kennych418/Multichannel-BT-Keyboard/Keyboard_BOM.xlsx

Sheet: Sheet1
Vendor | Package | Description | Quantity | Unit Price | Total Cost | Link | Datasheet
MODULES
Digikey | Module | BT Module HID & SPP | 3 | 15.73 | 47.19 | https://www.digikey.com/product-detail/en/microchip-technology/RN42-I-RM630/RN42-I-RM630-ND/6009311
Digikey | 402 | 10k Resistor | 4 | 0.1 | 0.4 | https://www.digikey.com/product-detail/en/yageo/RC0402FR-0710KL/311-10.0KLRCT-ND/729470
Digikey |  | AtMega32u4 | 1 | 4.2 | 4.2 | https://www.digikey.com/product-detail/en/microchip-technology/ATMEGA32U4-AUR/ATMEGA32U4-AURCT-ND/3440960
Digikey | HC-49/US | 16 MHz Crystal | 1 | 0.46 | 0.46 | https://www.digikey.com/product-detail/en/abracon-llc/ABLS2-16.000MHZ-D4Y-T/535-9875-1-ND/2001498
Digikey | 402 | 22pF Capacitor | 4 | 0.65 | 2.6 | https://www.digikey.com/product-detail/en/avx-corporation/04025A220FAT2A/478-5765-1-ND/2136357
Digikey | 402 | 10uF Capacitor | 2 | 0.47 | 0.94 | https://www.digikey.com/product-detail/en/samsung-electro-mechanics/CL05A106MP8NUB8/1276-6830-1-ND/5961689
Digikey | 402 | 1uF Capacitor | 2 | 0.1 | 0.2 | https://www.digikey.com/product-detail/en/samsung-electro-mechanics/CL05A105JQ5NNNC/1276-1444-1-ND/3889530
DECOUPLING
Digikey | 402 | 4.7uF Capacitor | 2 | 0.15 | 0.3 | https://www.digikey.com/product-detail/en/murata-electronics/GRM155R60J475ME47D/490-5915-1-ND/3719860
Digikey | 402 | 100nF Capacitor | 6 | 0.1 | 0.6 | https://www.digikey.com/product-detail/en/samsung-electro-mechanics/CL05B104KO5NNNC/1276-1001-1-ND/3889087
Battery
Digikey | Throughhole | Battery Clip | 8 | 0.32 | 2.56 | https://www.digikey.com/product-detail/en/keystone-electronics/92/36-92-ND/82326
USB
Digikey |  | Micro USB Type B | 1 | 0.78 | 0.78 | https://www.digikey.com/product-detail/en/amphenol-icc-fci/10118194-0001LF/609-4618-1-ND/2785382 | https://cdn.amphenol-icc.com/media/wysiwyg/files/documentation/datasheet/inputoutput/io_usb_micro.pdf
Digikey |  | 22ohm Resistor | 4 | 0.1 | 0.4 | https://www.digikey.com/product-detail/en/yageo/RC0402FR-0722RL/311-22.0LRCT-ND/729509
Voltage Reg
Digikey | 8-SOIC | Voltage Reg | 1 | 2.26 | 2.26 | https://www.digikey.com/product-detail/en/microchip-technology/MIC4680-3.3YM-TR/576-1552-1-ND/1121889
Digikey | 603 | 15uF Capacitor | 2 | 0.46 | 0.92 | https://www.digikey.com/product-detail/en/tdk-corporation/C1608X5R0J156M080AC/445-8027-1-ND/2792157
Digikey | 1206 | 220uF Capacitor | 1 | 1.52 | 1.52 | https://www.digikey.com/product-detail/en/murata-electronics/GRM31CR60J227ME11L/490-13970-1-ND/6155800
Digikey | 603 | 68uH Inductor | 2 | 0.27 | 0.54 | https://www.digikey.com/product-detail/en/GLFR1608T680M-LR/445-6155-1-ND/2465481/?itemSeq=308319238
Digikey | DO214AA | Zener Diode | 1 | 0.54 | 0.54 | https://www.digikey.com/product-detail/en/vishay-semiconductor-diodes-division/SS26-E3-52T/SS26-E3-52TGICT-ND/1091676
LED's
Digikey | 402 | 1k Resistor | 14 | $0.10 | 1.4 | https://www.digikey.com/product-detail/en/yageo/RC0402FR-071KL/311-1.00KLRCT-ND/729460 | https://industrial.panasonic.com/cdbs/www-data/pdf/RDM0000/AOA0000C307.pdf | Panasonic Electronic Components
Digikey | 603 | LEDs | 14 | $0.46 | 6.44 | https://www.digikey.com/product-detail/en/rohm-semiconductor/SML-D12U1WT86/SML-D12U1WT86CT-ND/5843858 | https://www.rohm.com/datasheet/SMLE13EC8T | Rohm Semiconductor
Reset Button
Digikey | - | Button | 5 | $0.15 | $0.15 | https://www.digikey.com/product-detail/en/c-k/RS-187R05A2-DS-MT-RT/CKN10361CT-ND/2747199
Digikey | 402 | 100nF Capacitor | 5 | 0.1 | 0.5 | https://www.digikey.com/product-detail/en/samsung-electro-mechanics/CL05B104KO5NNNC/1276-1001-1-ND/3889087
Keys
Digikey | 402 | 1uF Capacitor | 75 | 0.043 | 3.225 | https://www.digikey.com/product-detail/en/samsung-electro-mechanics/CL05A105JQ5NNNC/1276-1444-1-ND/3889530
Digikey | 402 | 1k Resistor | 75 | 0.016 | 1.2 | https://www.digikey.com/product-detail/en/yageo/RC0402FR-071KL/311-1.00KLRCT-ND/729460
Power Switch
Digikey |  | Slide Switch | 1 | 0.91 | 0.91 | https://www.digikey.com/product-detail/en/nidec-copal-electronics/CL-SB-12B-01T/563-1318-6-ND/3507883
 |  |  |  | Total Cost | 80.235

Sheet: Sheet2
MCU
RN42

Sheet: Sheet3
USB
