kennych418/Multichannel-BT-Keyboard/PCB CAD/keyboardPCB2.sch

## EAGLE design PCB CAD/keyboardPCB2.sch (2020-02-17)

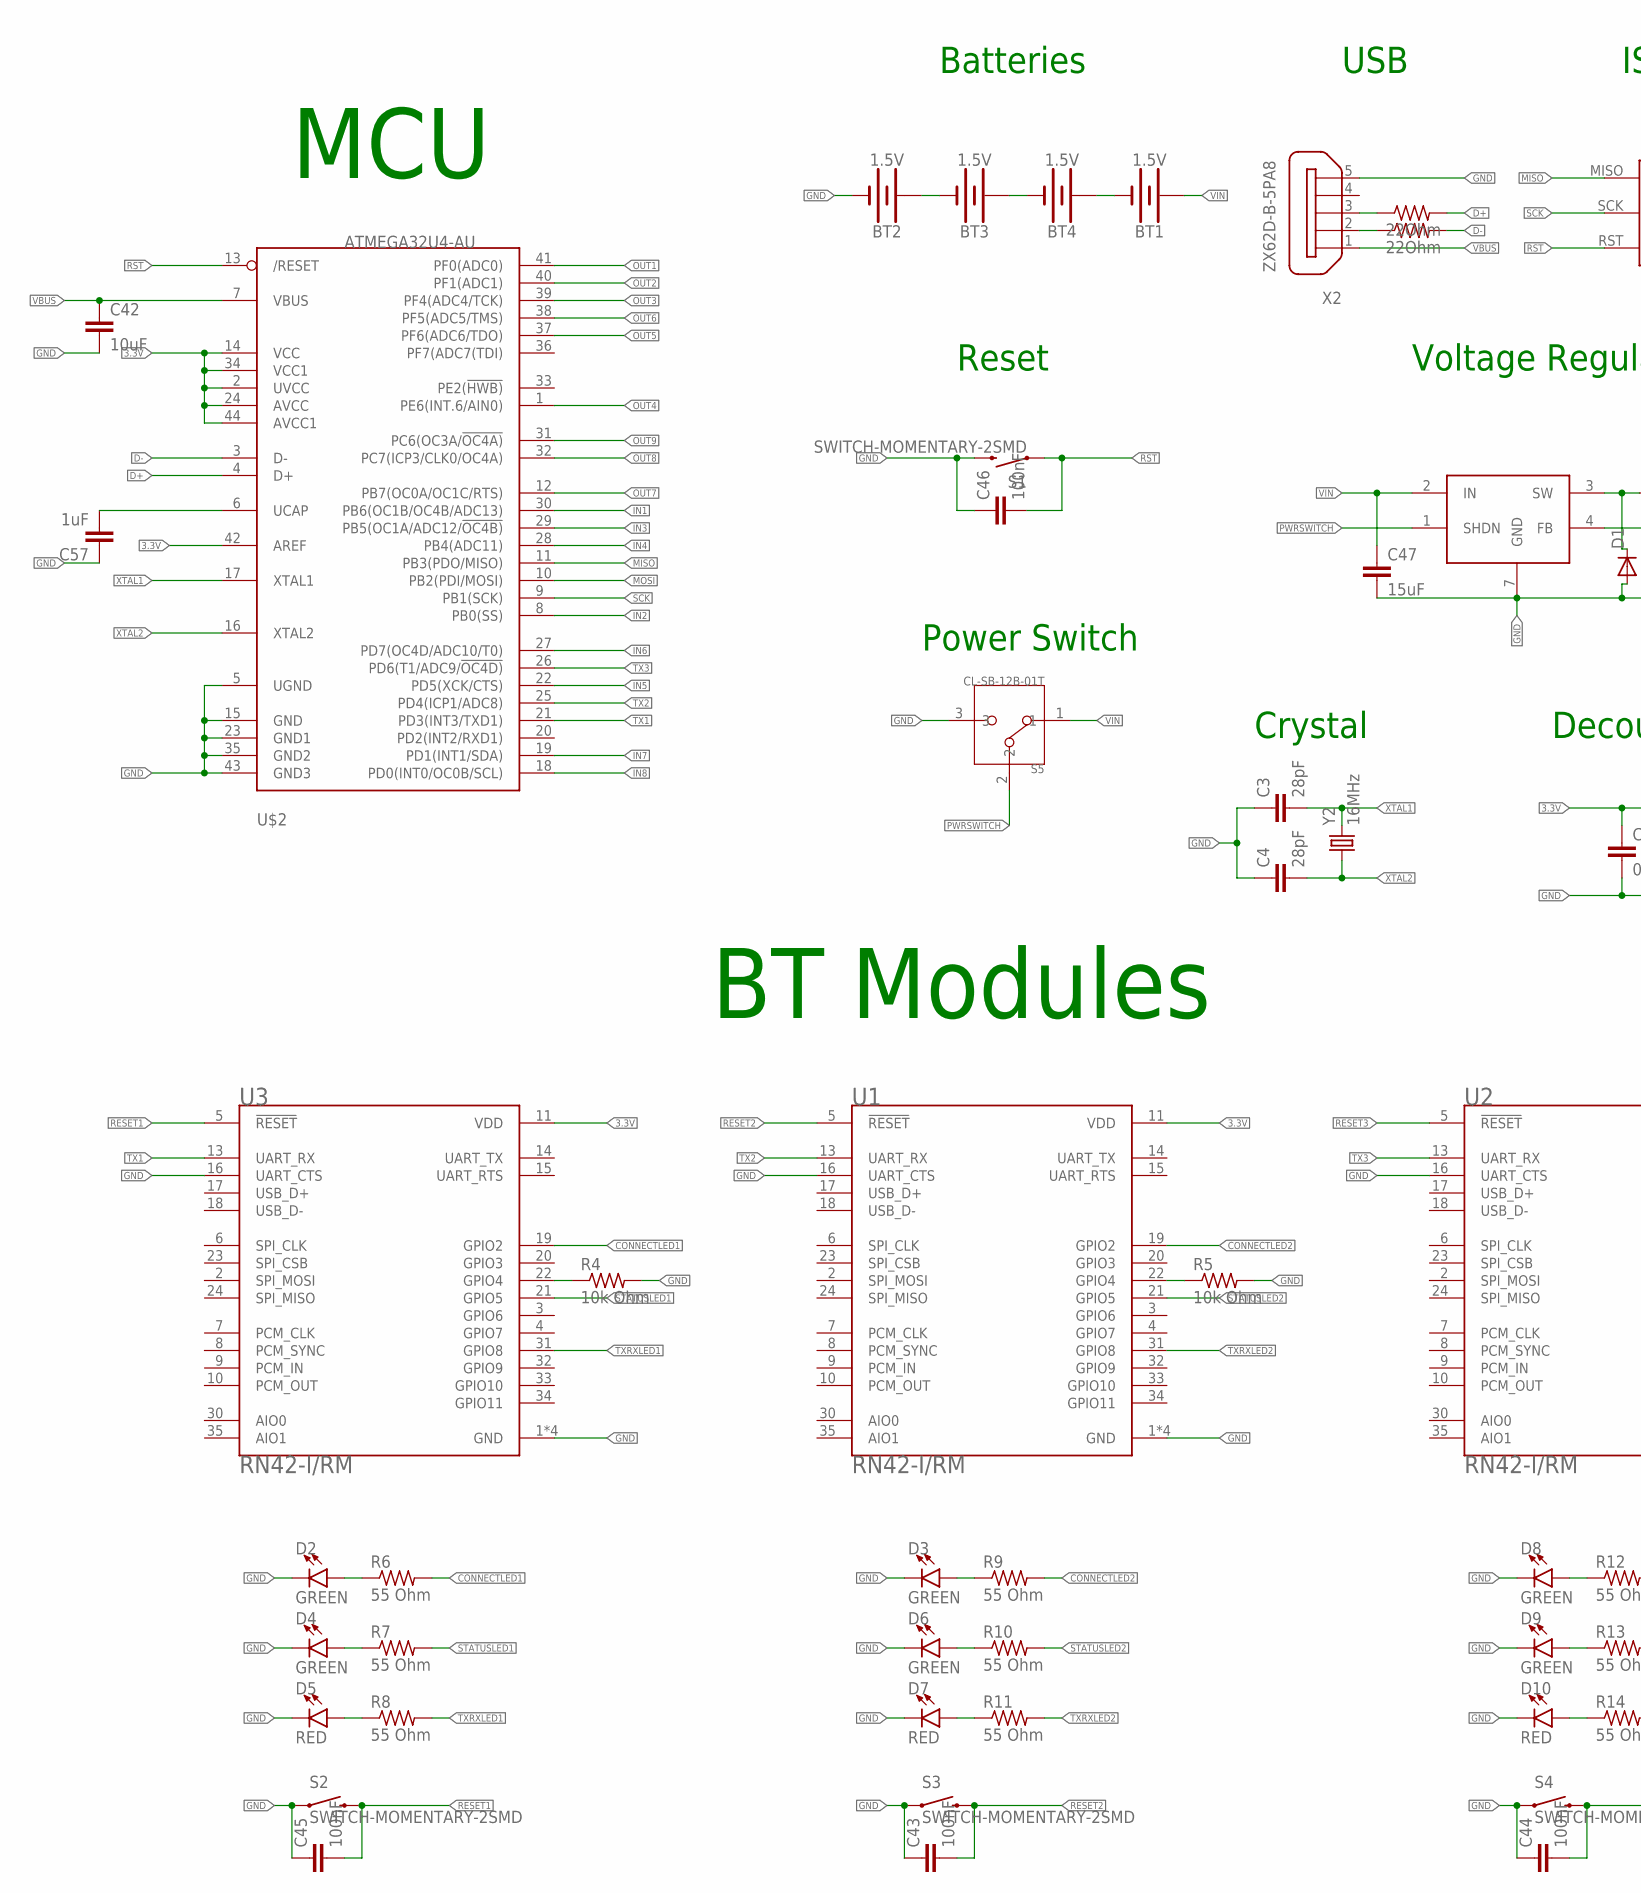
[picture p1: schematic keyboardPCB2.sch, part in row 1, column 1]

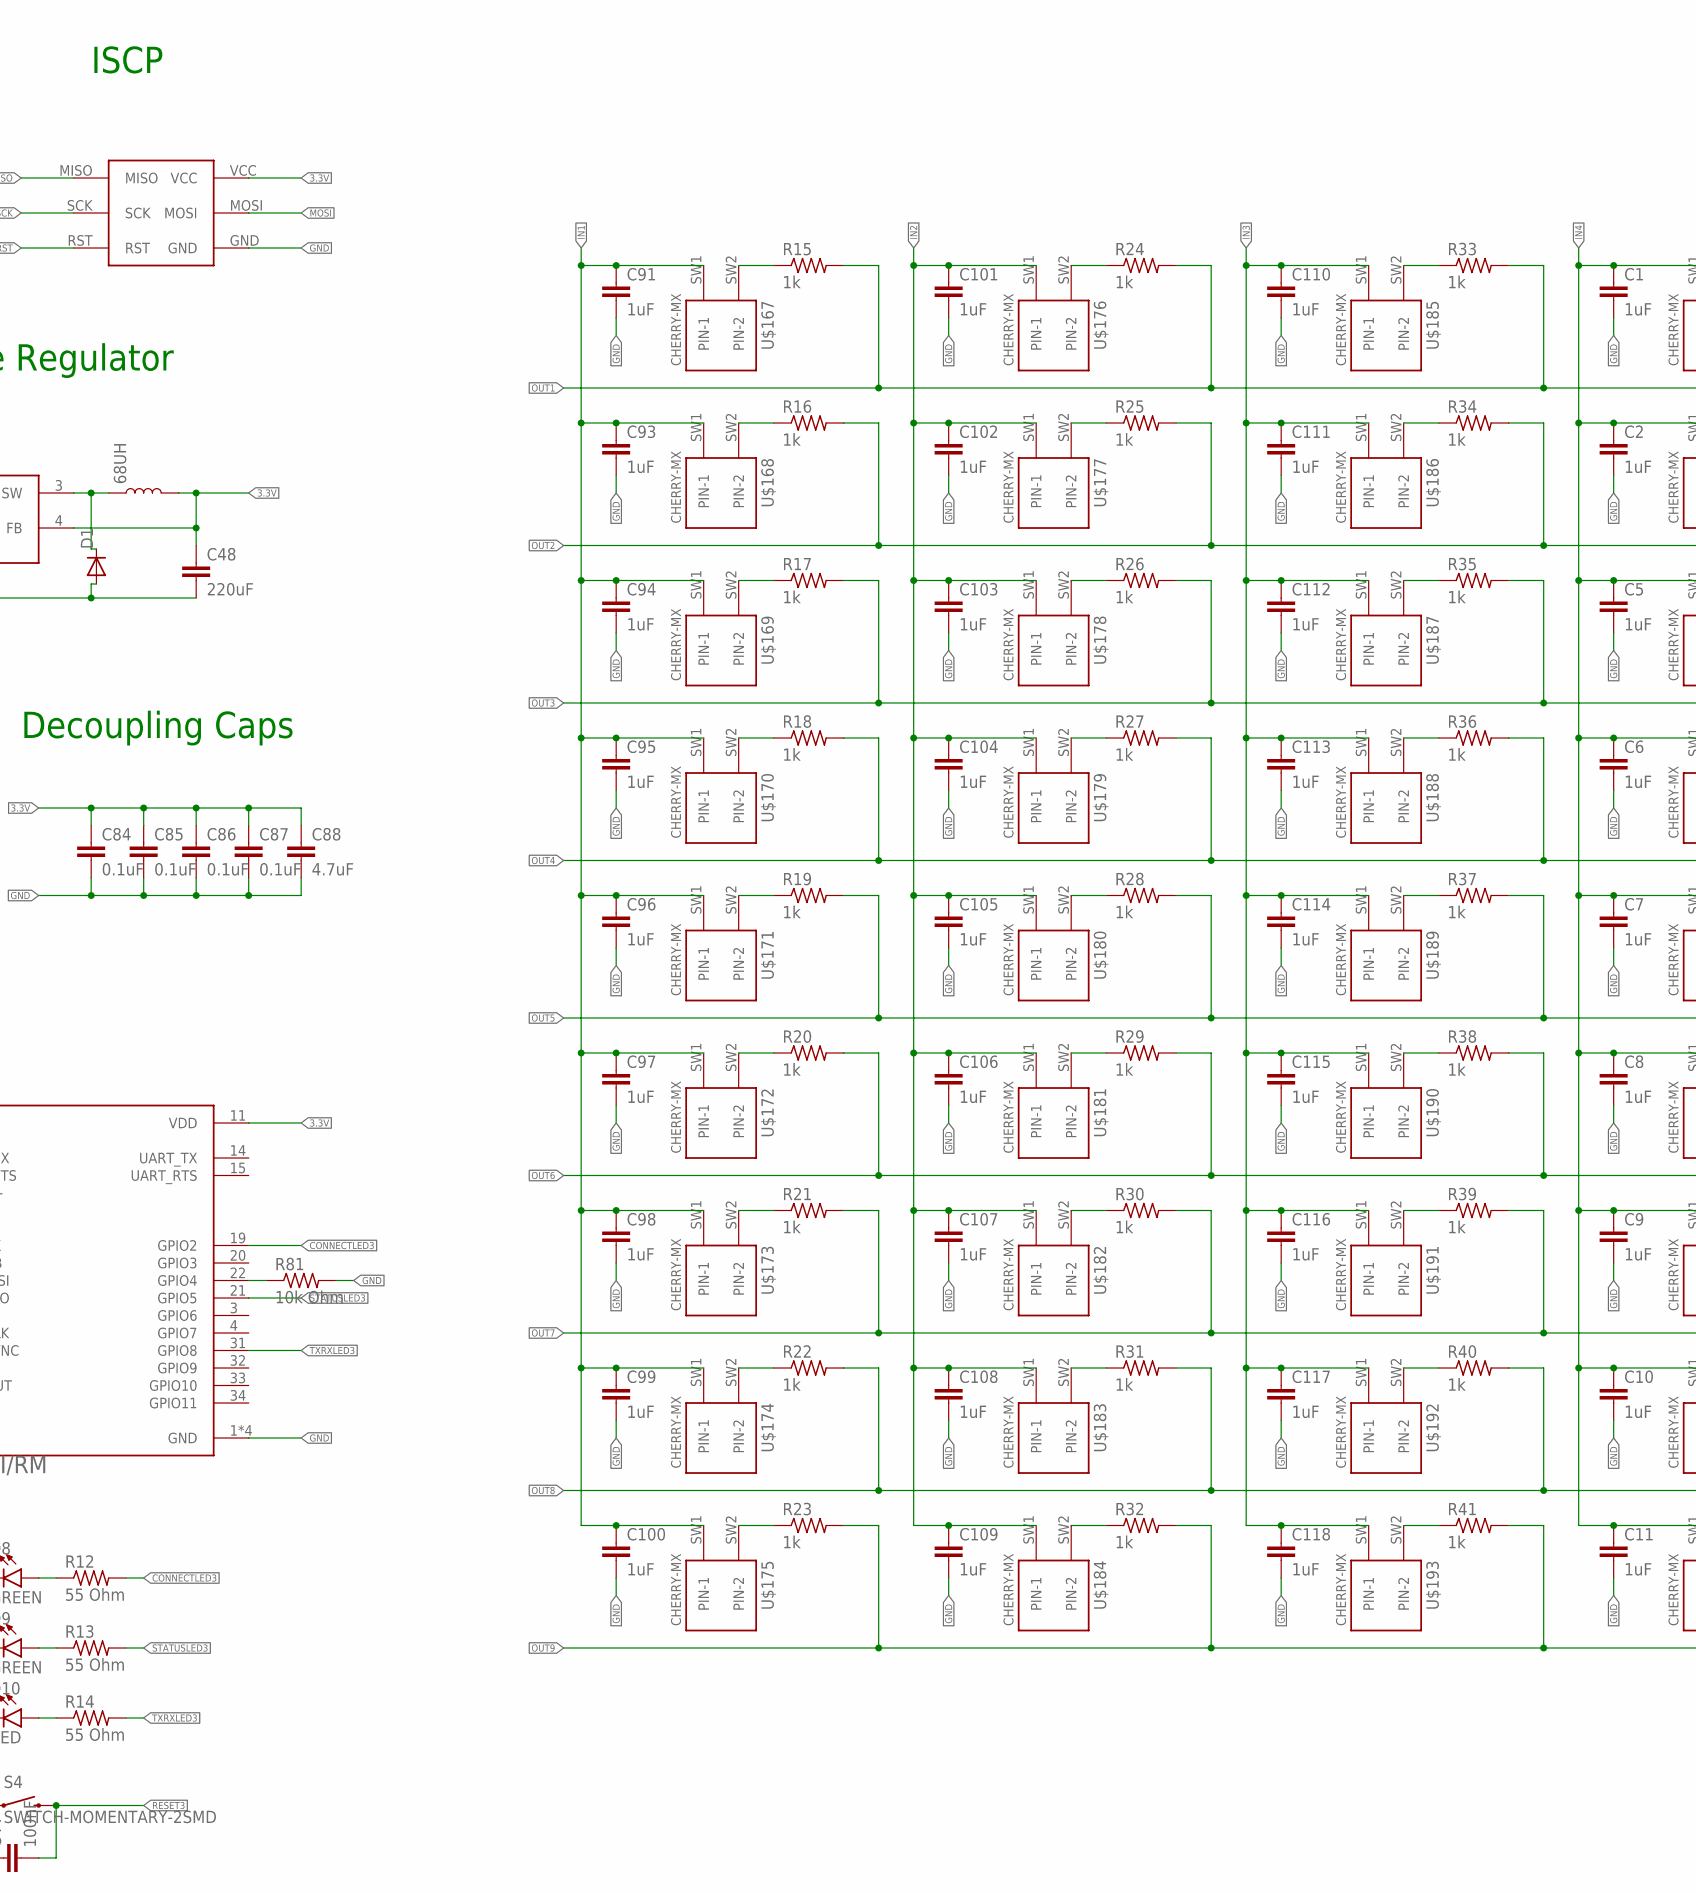
[picture p2: schematic keyboardPCB2.sch, part in row 1, column 2]

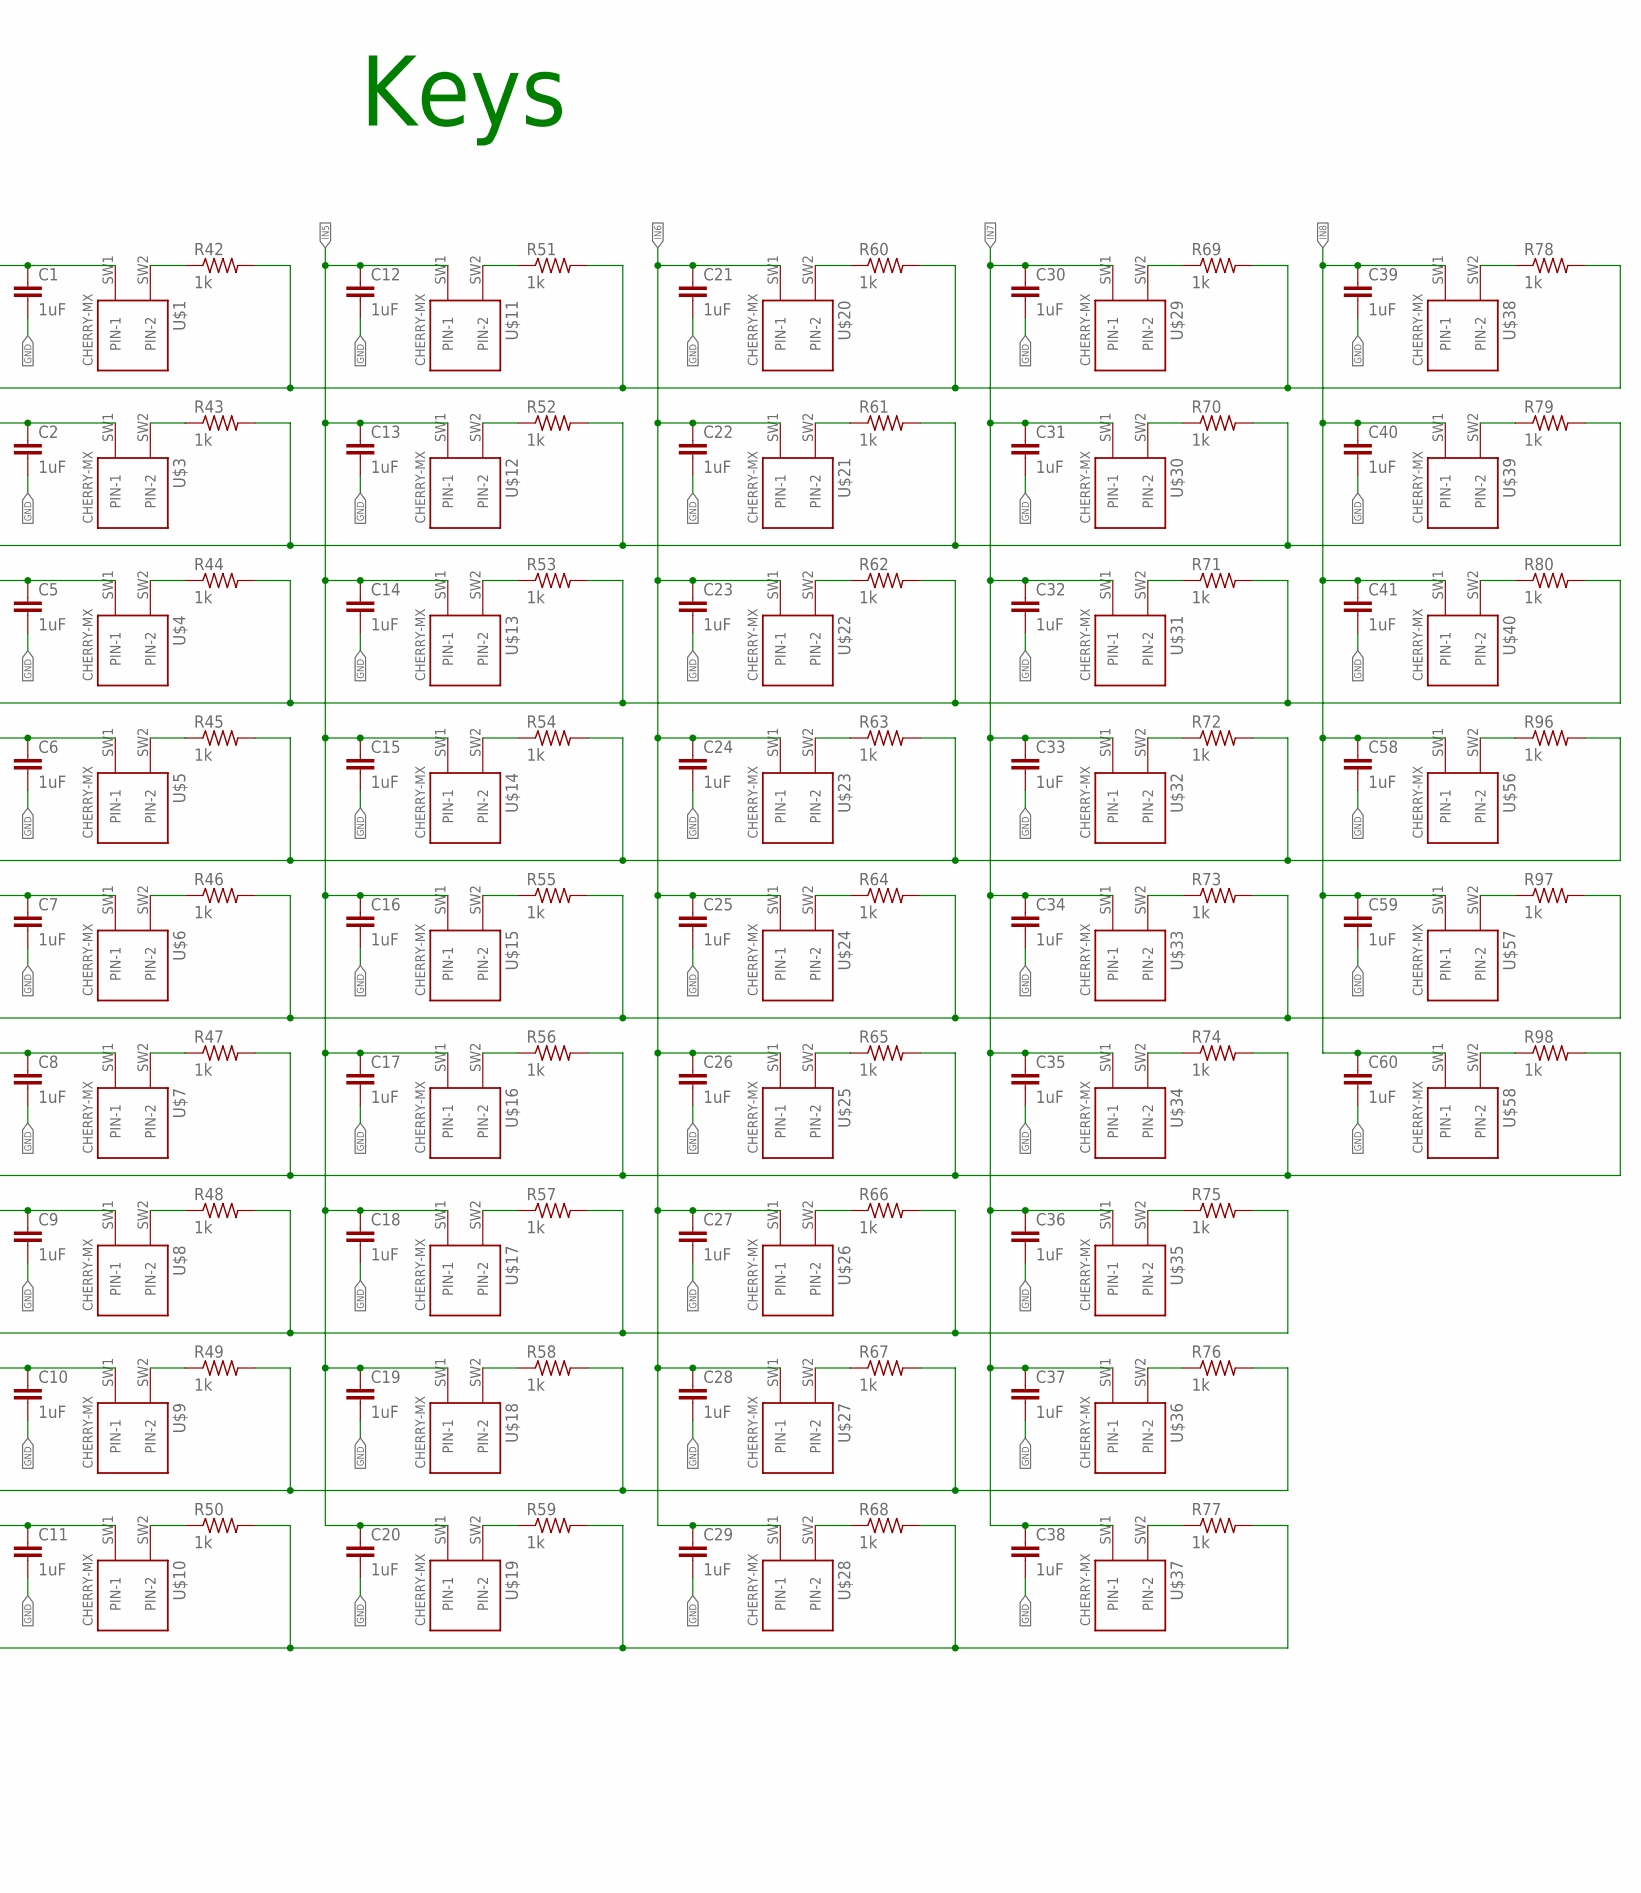
[picture p3: schematic keyboardPCB2.sch, part in row 1, column 3]

Parts:
68UH: 33nH/±5%/500mA; 0603
BT1, BT2, BT3, BT4: 1.5V; BATTERY-AA
C1, C2, C5, C6, C7, C8, C9, C10, C11, C12, C13, C14, C15, C16, C17, C18, C19, C20, C21, C22, C23, C24, C25, C26, C27, C28, C29, C30, C31, C32, C33, C34, C35, C36, C37, C38, C39, C40, C41, C57, C58, C59, C60, C91, C93, C94, C95, C96, C97, C98, C99, C100, C101, C102, C103, C104, C105, C106, C107, C108, C109, C110, C111, C112, C113, C114, C115, C116, C117, C118: 1uF; C0402K
C3, C4: 28pF; C0402K
C42: 10uF; C0402K
C43, C44, C45, C46: 100nF; C0402K
C47: 15uF; C0603K
C48: 220uF; C1206
C84, C85, C86, C87: 0.1uF; C0402K
C88: 4.7uF; C0402K
D1: S2A; DO214AA
D2, D3, D4, D6, D8, D9: GREEN; LED-0603
D5, D7, D10: RED; LED-0603
R2, R3: 22Ohm; R0402
R4, R5, R81: 10k Ohm; R0402
R6, R7, R8, R9, R10, R11, R12, R13, R14: 55 Ohm; R0402
R15, R16, R17, R18, R19, R20, R21, R22, R23, R24, R25, R26, R27, R28, R29, R30, R31, R32, R33, R34, R35, R36, R37, R38, R39, R40, R41, R42, R43, R44, R45, R46, R47, R48, R49, R50, R51, R52, R53, R54, R55, R56, R57, R58, R59, R60, R61, R62, R63, R64, R65, R66, R67, R68, R69, R70, R71, R72, R73, R74, R75, R76, R77, R78, R79, R80, R96, R97, R98: 1k; R0402
S1, S2, S3, S4: SWITCH-MOMENTARY-2SMD; TACTILE-SWITCH-SMD
S5: CL-SB-12B-01T; CL-SB-12B
U1, U2, U3: RN42-I/RM; XCVR_RN42-I/RM
U$1, U$3, U$4, U$5, U$6, U$7, U$8, U$9, U$10, U$11, U$12, U$13, U$14, U$15, U$16, U$17, U$18, U$19, U$20, U$21, U$22, U$23, U$24, U$25, U$26, U$27, U$28, U$29, U$30, U$31, U$32, U$33, U$34, U$35, U$36, U$37, U$38, U$39, U$40, U$56, U$57, U$58, U$167, U$168, U$169, U$170, U$171, U$172, U$173, U$174, U$175, U$176, U$177, U$178, U$179, U$180, U$181, U$182, U$183, U$184, U$185, U$186, U$187, U$188, U$189, U$190, U$191, U$192, U$193: CHERRY-MX
U$2: ATMEGA32U4-AU; TQFP44
U$59: AVR-ISP
U$166: MIC4680; SOIC-8
X2: ZX62D-B-5PA8
Y2: 16MHz; HC49UP

Connections:
3.3V: 68UH.2, C48.1, C84.1, C85.1, C86.1, C87.1, C88.1, U1.11 (VDD), U2.11 (VDD), U3.11 (VDD), U$2.2 (UVCC), U$2.14 (VCC), U$2.24 (AVCC), U$2.34 (VCC1), U$2.42 (AREF), U$2.44 (AVCC1), U$59.VCC, U$166.4 (FB)
CONNECTLED1: R6.2, U3.19 (GPIO2)
CONNECTLED2: R9.2, U1.19 (GPIO2)
CONNECTLED3: R12.2, U2.19 (GPIO2)
D+: R2.2, U$2.4 (D+)
D-: R3.2, U$2.3 (D-)
GND: BT2.GND@1 (-), C1.2, C2.2, C3.1, C4.1, C5.2, C6.2, C7.2, C8.2, C9.2, C10.2, C11.2, C12.2, C13.2, C14.2, C15.2, C16.2, C17.2, C18.2, C19.2, C20.2, C21.2, C22.2, C23.2, C24.2, C25.2, C26.2, C27.2, C28.2, C29.2, C30.2, C31.2, C32.2, C33.2, C34.2, C35.2, C36.2, C37.2, C38.2, C39.2, C40.2, C41.2, C42.2, C43.1, C44.1, C45.1, C46.1, C47.2, C48.2, C57.1, C58.2, C59.2, C60.2, C84.2, C85.2, C86.2, C87.2, C88.2, C91.2, C93.2, C94.2, C95.2, C96.2, C97.2, C98.2, C99.2, C100.2, C101.2, C102.2, C103.2, C104.2, C105.2, C106.2, C107.2, C108.2, C109.2, C110.2, C111.2, C112.2, C113.2, C114.2, C115.2, C116.2, C117.2, C118.2, D1.A, D2.C, D3.C, D4.C, D5.C, D6.C, D7.C, D8.C, D9.C, D10.C, R4.2, R5.2, R81.2, S1.3 (2), S2.1, S3.1, S4.1, S5.3, U1.1 (GND), U1.16 (UART_CTS), U2.1 (GND), U2.16 (UART_CTS), U3.1 (GND), U3.16 (UART_CTS), U$2.5 (UGND), U$2.15 (GND), U$2.23 (GND1), U$2.35 (GND2), U$2.43 (GND3), U$59.GND, U$166.5 (GND), U$166.6 (GND), U$166.7 (GND), U$166.8 (GND), X2.5
IN1: C91.1, C93.1, C94.1, C95.1, C96.1, C97.1, C98.1, C99.1, C100.1, U$2.30 (PB6(OC1B/OC4B/ADC13)), U$167.SW1 (PIN-1), U$168.SW1 (PIN-1), U$169.SW1 (PIN-1), U$170.SW1 (PIN-1), U$171.SW1 (PIN-1), U$172.SW1 (PIN-1), U$173.SW1 (PIN-1), U$174.SW1 (PIN-1), U$175.SW1 (PIN-1)
IN2: C101.1, C102.1, C103.1, C104.1, C105.1, C106.1, C107.1, C108.1, C109.1, U$2.8 (PB0(SS)), U$176.SW1 (PIN-1), U$177.SW1 (PIN-1), U$178.SW1 (PIN-1), U$179.SW1 (PIN-1), U$180.SW1 (PIN-1), U$181.SW1 (PIN-1), U$182.SW1 (PIN-1), U$183.SW1 (PIN-1), U$184.SW1 (PIN-1)
IN3: C110.1, C111.1, C112.1, C113.1, C114.1, C115.1, C116.1, C117.1, C118.1, U$2.29 (PB5(OC1A/ADC12/!OC4B)), U$185.SW1 (PIN-1), U$186.SW1 (PIN-1), U$187.SW1 (PIN-1), U$188.SW1 (PIN-1), U$189.SW1 (PIN-1), U$190.SW1 (PIN-1), U$191.SW1 (PIN-1), U$192.SW1 (PIN-1), U$193.SW1 (PIN-1)
IN4: C1.1, C2.1, C5.1, C6.1, C7.1, C8.1, C9.1, C10.1, C11.1, U$1.SW1 (PIN-1), U$2.28 (PB4(ADC11)), U$3.SW1 (PIN-1), U$4.SW1 (PIN-1), U$5.SW1 (PIN-1), U$6.SW1 (PIN-1), U$7.SW1 (PIN-1), U$8.SW1 (PIN-1), U$9.SW1 (PIN-1), U$10.SW1 (PIN-1)
IN5: C12.1, C13.1, C14.1, C15.1, C16.1, C17.1, C18.1, C19.1, C20.1, U$2.22 (PD5(XCK/CTS)), U$11.SW1 (PIN-1), U$12.SW1 (PIN-1), U$13.SW1 (PIN-1), U$14.SW1 (PIN-1), U$15.SW1 (PIN-1), U$16.SW1 (PIN-1), U$17.SW1 (PIN-1), U$18.SW1 (PIN-1), U$19.SW1 (PIN-1)
IN6: C21.1, C22.1, C23.1, C24.1, C25.1, C26.1, C27.1, C28.1, C29.1, U$2.27 (PD7(OC4D/ADC10/T0)), U$20.SW1 (PIN-1), U$21.SW1 (PIN-1), U$22.SW1 (PIN-1), U$23.SW1 (PIN-1), U$24.SW1 (PIN-1), U$25.SW1 (PIN-1), U$26.SW1 (PIN-1), U$27.SW1 (PIN-1), U$28.SW1 (PIN-1)
IN7: C30.1, C31.1, C32.1, C33.1, C34.1, C35.1, C36.1, C37.1, C38.1, U$2.19 (PD1(INT1/SDA)), U$29.SW1 (PIN-1), U$30.SW1 (PIN-1), U$31.SW1 (PIN-1), U$32.SW1 (PIN-1), U$33.SW1 (PIN-1), U$34.SW1 (PIN-1), U$35.SW1 (PIN-1), U$36.SW1 (PIN-1), U$37.SW1 (PIN-1)
IN8: C39.1, C40.1, C41.1, C58.1, C59.1, C60.1, U$2.18 (PD0(INT0/OC0B/SCL)), U$38.SW1 (PIN-1), U$39.SW1 (PIN-1), U$40.SW1 (PIN-1), U$56.SW1 (PIN-1), U$57.SW1 (PIN-1), U$58.SW1 (PIN-1)
MISO: U$2.11 (PB3(PDO/MISO)), U$59.MISO
MOSI: U$2.10 (PB2(PDI/MOSI)), U$59.MOSI
unnamed: R42.1, U$1.SW2 (PIN-2)
unnamed: BT2.PWR@1 (+), BT3.GND@1 (-)
unnamed: C57.2, U$2.6 (UCAP)
unnamed: BT3.PWR@1 (+), BT4.GND@1 (-)
unnamed: R96.1, U$56.SW2 (PIN-2)
unnamed: R43.1, U$3.SW2 (PIN-2)
unnamed: R4.1, U3.22 (GPIO4)
unnamed: R97.1, U$57.SW2 (PIN-2)
unnamed: D2.A, R6.1
unnamed: D4.A, R7.1
unnamed: R44.1, U$4.SW2 (PIN-2)
unnamed: R98.1, U$58.SW2 (PIN-2)
unnamed: BT1.GND@1 (-), BT4.PWR@1 (+)
unnamed: R45.1, U$5.SW2 (PIN-2)
unnamed: D5.A, R8.1
unnamed: 68UH.1, D1.C, U$166.3 (SW)
unnamed: R46.1, U$6.SW2 (PIN-2)
unnamed: R47.1, U$7.SW2 (PIN-2)
unnamed: D3.A, R9.1
unnamed: D6.A, R10.1
unnamed: D7.A, R11.1
unnamed: D8.A, R12.1
unnamed: R48.1, U$8.SW2 (PIN-2)
unnamed: D9.A, R13.1
unnamed: R5.1, U1.22 (GPIO4)
unnamed: R49.1, U$9.SW2 (PIN-2)
unnamed: D10.A, R14.1
unnamed: R50.1, U$10.SW2 (PIN-2)
unnamed: R2.1, X2.3
unnamed: R51.1, U$11.SW2 (PIN-2)
unnamed: R52.1, U$12.SW2 (PIN-2)
unnamed: R53.1, U$13.SW2 (PIN-2)
unnamed: R54.1, U$14.SW2 (PIN-2)
unnamed: R24.1, U$176.SW2 (PIN-2)
unnamed: R55.1, U$15.SW2 (PIN-2)
unnamed: R15.1, U$167.SW2 (PIN-2)
unnamed: R56.1, U$16.SW2 (PIN-2)
unnamed: R57.1, U$17.SW2 (PIN-2)
unnamed: R58.1, U$18.SW2 (PIN-2)
unnamed: R3.1, X2.2
unnamed: R59.1, U$19.SW2 (PIN-2)
unnamed: R60.1, U$20.SW2 (PIN-2)
unnamed: R61.1, U$21.SW2 (PIN-2)
unnamed: R62.1, U$22.SW2 (PIN-2)
unnamed: R63.1, U$23.SW2 (PIN-2)
unnamed: R64.1, U$24.SW2 (PIN-2)
unnamed: R65.1, U$25.SW2 (PIN-2)
unnamed: R66.1, U$26.SW2 (PIN-2)
unnamed: R67.1, U$27.SW2 (PIN-2)
unnamed: R16.1, U$168.SW2 (PIN-2)
unnamed: R68.1, U$28.SW2 (PIN-2)
unnamed: R69.1, U$29.SW2 (PIN-2)
unnamed: R81.1, U2.22 (GPIO4)
unnamed: R25.1, U$177.SW2 (PIN-2)
unnamed: R70.1, U$30.SW2 (PIN-2)
unnamed: R71.1, U$31.SW2 (PIN-2)
unnamed: R72.1, U$32.SW2 (PIN-2)
unnamed: R73.1, U$33.SW2 (PIN-2)
unnamed: R17.1, U$169.SW2 (PIN-2)
unnamed: R74.1, U$34.SW2 (PIN-2)
unnamed: R75.1, U$35.SW2 (PIN-2)
unnamed: R76.1, U$36.SW2 (PIN-2)
unnamed: R77.1, U$37.SW2 (PIN-2)
unnamed: R78.1, U$38.SW2 (PIN-2)
unnamed: R79.1, U$39.SW2 (PIN-2)
unnamed: R80.1, U$40.SW2 (PIN-2)
unnamed: R18.1, U$170.SW2 (PIN-2)
unnamed: R26.1, U$178.SW2 (PIN-2)
unnamed: R19.1, U$171.SW2 (PIN-2)
unnamed: R20.1, U$172.SW2 (PIN-2)
unnamed: R27.1, U$179.SW2 (PIN-2)
unnamed: R21.1, U$173.SW2 (PIN-2)
unnamed: R22.1, U$174.SW2 (PIN-2)
unnamed: R28.1, U$180.SW2 (PIN-2)
unnamed: R23.1, U$175.SW2 (PIN-2)
unnamed: R29.1, U$181.SW2 (PIN-2)
unnamed: R30.1, U$182.SW2 (PIN-2)
unnamed: R31.1, U$183.SW2 (PIN-2)
unnamed: R32.1, U$184.SW2 (PIN-2)
unnamed: R33.1, U$185.SW2 (PIN-2)
unnamed: R34.1, U$186.SW2 (PIN-2)
unnamed: R35.1, U$187.SW2 (PIN-2)
unnamed: R36.1, U$188.SW2 (PIN-2)
unnamed: R37.1, U$189.SW2 (PIN-2)
unnamed: R38.1, U$190.SW2 (PIN-2)
unnamed: R39.1, U$191.SW2 (PIN-2)
unnamed: R40.1, U$192.SW2 (PIN-2)
unnamed: R41.1, U$193.SW2 (PIN-2)
OUT1: R15.2, R24.2, R33.2, R42.2, R51.2, R60.2, R69.2, R78.2, U$2.41 (PF0(ADC0))
OUT2: R16.2, R25.2, R34.2, R43.2, R52.2, R61.2, R70.2, R79.2, U$2.40 (PF1(ADC1))
OUT3: R17.2, R26.2, R35.2, R44.2, R53.2, R62.2, R71.2, R80.2, U$2.39 (PF4(ADC4/TCK))
OUT4: R18.2, R27.2, R36.2, R45.2, R54.2, R63.2, R72.2, R96.2, U$2.1 (PE6(INT.6/AIN0))
OUT5: R19.2, R28.2, R37.2, R46.2, R55.2, R64.2, R73.2, R97.2, U$2.37 (PF6(ADC6/TDO))
OUT6: R20.2, R29.2, R38.2, R47.2, R56.2, R65.2, R74.2, R98.2, U$2.38 (PF5(ADC5/TMS))
OUT7: R21.2, R30.2, R39.2, R48.2, R57.2, R66.2, R75.2, U$2.12 (PB7(OC0A/OC1C/RTS))
OUT8: R22.2, R31.2, R40.2, R49.2, R58.2, R67.2, R76.2, U$2.32 (PC7(ICP3/CLK0/OC4A))
OUT9: R23.2, R32.2, R41.2, R50.2, R59.2, R68.2, R77.2, U$2.31 (PC6(OC3A/!OC4A))
PWRSWITCH: S5.2, U$166.1 (SHDN)
RESET1: C45.2, S2.3 (2), U3.5 (!RESET)
RESET2: C43.2, S3.3 (2), U1.5 (!RESET)
RESET3: C44.2, S4.3 (2), U2.5 (!RESET)
RST: C46.2, S1.1, U$2.13 (/RESET), U$59.RST
SCK: U$2.9 (PB1(SCK)), U$59.SCK
STATUSLED1: R7.2, U3.21 (GPIO5)
STATUSLED2: R10.2, U1.21 (GPIO5)
STATUSLED3: R13.2, U2.21 (GPIO5)
TX1: U3.13 (UART_RX), U$2.21 (PD3(INT3/TXD1))
TX2: U1.13 (UART_RX), U$2.25 (PD4(ICP1/ADC8))
TX3: U2.13 (UART_RX), U$2.26 (PD6(T1/ADC9/!OC4D))
TXRXLED1: R8.2, U3.31 (GPIO8)
TXRXLED2: R11.2, U1.31 (GPIO8)
TXRXLED3: R14.2, U2.31 (GPIO8)
VBUS: C42.1, U$2.7 (VBUS), X2.1
VIN: BT1.PWR@1 (+), C47.1, S5.1, U$166.2 (IN)
XTAL1: C3.2, U$2.17 (XTAL1), Y2.2
XTAL2: C4.2, U$2.16 (XTAL2), Y2.1

Notes on the sheet:
Keys
MCU
BT Modules
Voltage Regulator
Batteries
USB
ISCP
Crystal
Decoupling Caps
Reset
Power Switch
