kennych418/Multichannel-BT-Keyboard/(commit log)

2020-02-17 Adding PCB and Code Files
    [Keyboard_BOM.xlsx, keyboardPCB.brd, keyboardPCB.sch]
2020-08-15 Add low power optimizations
